papamidas/H7DDCADC/README.md

# H7DDCADC
A direct conversion software defined radio (SDR) for the shortwave range   

work in progress
