papamidas/H7DDCADC/TI_SPI/TISPI1.pdf

Making TI's ADC3660 compatible to TI's SPI mode

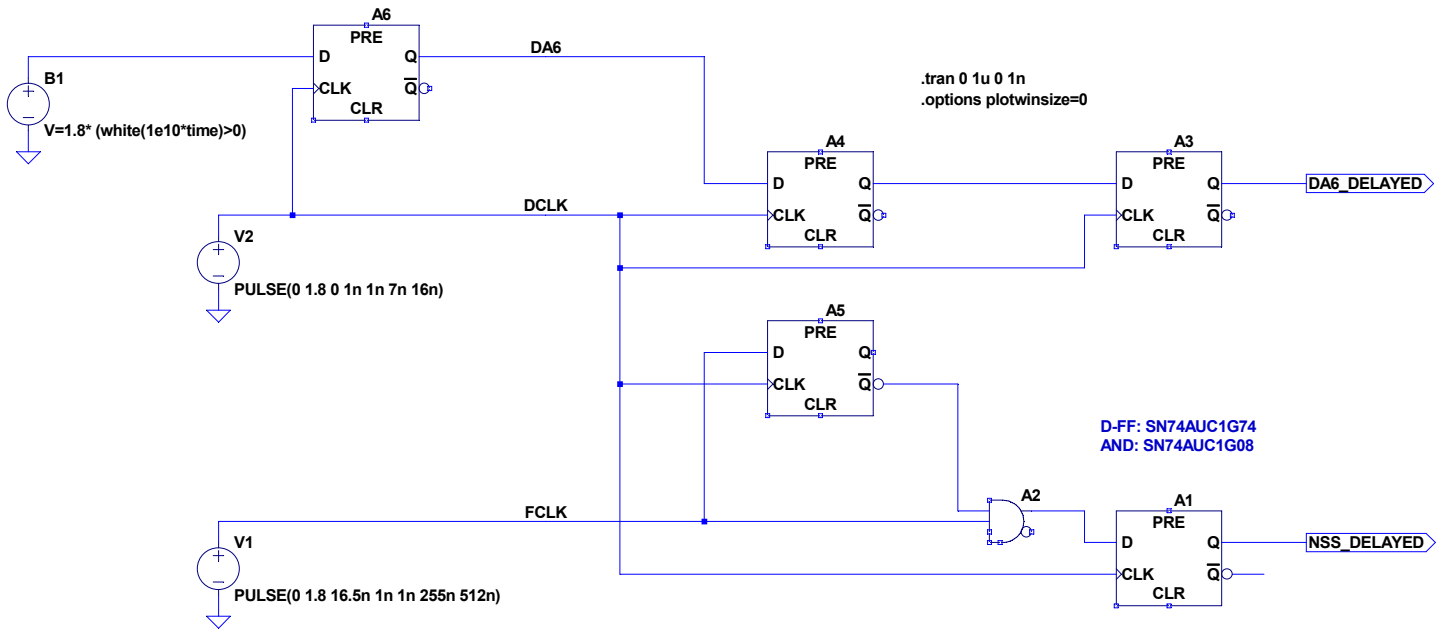
[picture p1: figure]
CLK; PRE; CLR; PULSE(0 1.8 16.5n 1n 1n 255n 512n); PULSE(0 1.8 0 1n 1n 7n 16n); V=1.8* (white(1e10*time)>0); NSS_DELAYED; FCLK; DCLK; DA6_DELAYED; .tran 0 1u 0 1n .options plotwinsize=0; D-FF: SN74AUC1G74 AND: SN74AUC1G08

# --- C:\Users\chrau\Google Drive\Amateurfunk\KiCAD\H7DDCADC\TI_SPI\TISPI.asc ---
