papamidas/H7DDCADC/TI_SPI/TI_SPI_Timing.png

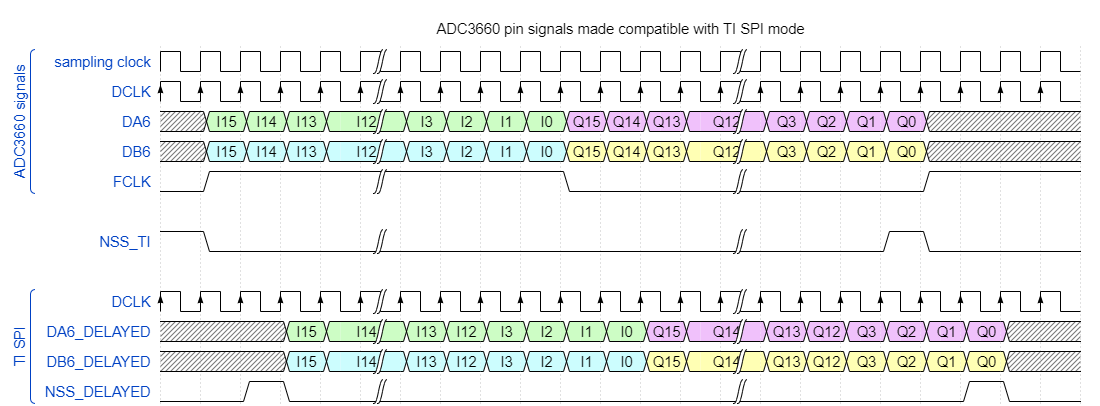
TI_SPI/TI_SPI_Timing.png
