papamidas/H7DDCADC/TI_SPI/Timing_Simu.jpg

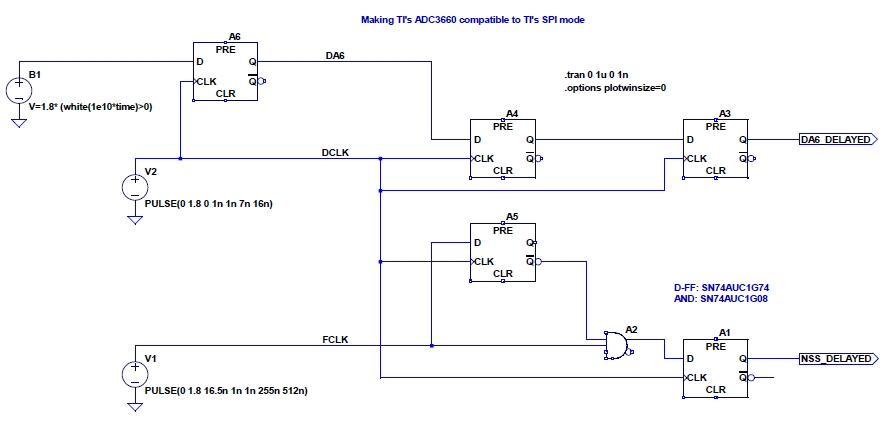
TI_SPI/Timing_Simu.jpg
