papamidas/H7DDCADC/TI_SPI/TISPI.asc

A1: dflop; Ref=0.9; Vhigh=1.8  Vlow=0; Td=1.5n   Trise=1n Tfall=1n
A2: and; Vhigh=1.8 Vlow=0; Td=1.5n Trise=1n Tfall=1n
A3: dflop; Ref=0.9; Vhigh=1.8  Vlow=0; Td=1.5n   Trise=1n Tfall=1n
A4: dflop; Ref=0.9; Vhigh=1.8  Vlow=0; Td=1.5n   Trise=1n Tfall=1n
A5: dflop; Ref=0.9; Vhigh=1.8  Vlow=0; Td=1.5n   Trise=1n Tfall=1n
A6: dflop; Ref=0.9; Vhigh=1.8  Vlow=0; Td=1.5n   Trise=1n Tfall=1n
B1: bv; V=1.8* (white(1e10*time)>0)
V1: voltage; PULSE(0 1.8 16.5n 1n 1n 255n 512n)
V2: voltage; PULSE(0 1.8 0 1n 1n 7n 16n)
Named nets: NSS_DELAYED, 0, FCLK, DCLK, DA6, DA6_DELAYED
.tran 0 1u 0 1n
.options plotwinsize=0
D-FF: SN74AUC1G74
AND: SN74AUC1G08
Making TI's ADC3660 compatible to TI's SPI mode
