papamidas/H7DDCADC/H7DDCADC.kicad_pcb

## KiCad design H7DDCADC.kicad_pcb (2022-07-26)

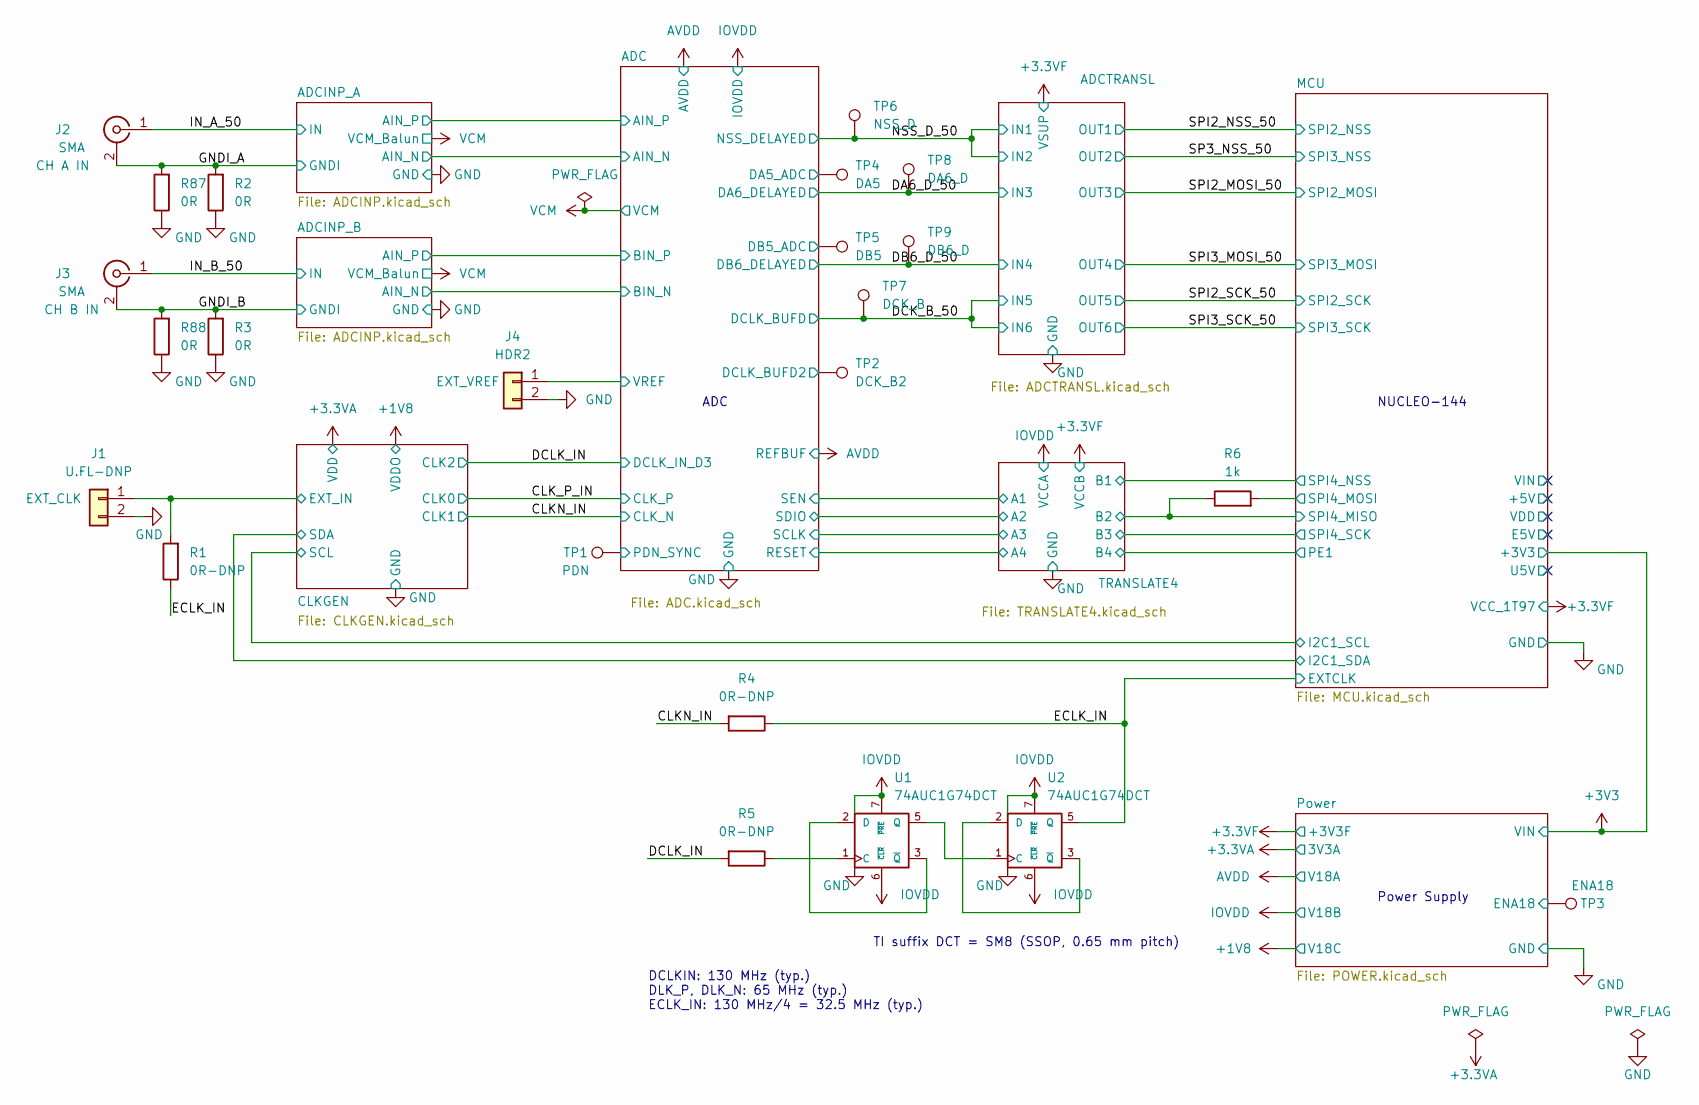
[picture p4: schematic H7DDCADC.kicad_sch]

Parts:
J1: U.FL-DNP; U.FL_Hirose_U.FL-R-SMT-1_Vertical
J2, J3: SMA; SMA_Wurth_60312002114503_Vertical
J4: HDR2; PinHeader_1x02_P2.54mm_Vertical
R1, R4, R5: 0R-DNP; R_0805_2012Metric
R2, R3, R87, R88: 0R; R_0805_2012Metric
R6: 1k; R_0805_2012Metric
TP1: PDN; TestPoint_THTPad_D1.5mm_Drill0.7mm
TP2: DCK_B2; TestPoint_THTPad_D1.5mm_Drill0.7mm
TP3: ENA18; TestPoint_THTPad_D1.5mm_Drill0.7mm
TP4: DA5; TestPoint_THTPad_D1.5mm_Drill0.7mm
TP5: DB5; TestPoint_THTPad_D1.5mm_Drill0.7mm
TP6: NSS_D; TestPoint_THTPad_D1.5mm_Drill0.7mm
TP7: DCK_B; TestPoint_THTPad_D1.5mm_Drill0.7mm
TP8: DA6_D; TestPoint_THTPad_D1.5mm_Drill0.7mm
TP9: DB6_D; TestPoint_THTPad_D1.5mm_Drill0.7mm
U1, U2: 74AUC1G74DCT; VSSOP-8_2.4x2.1mm_P0.5mm

Connections:
/ADC/DA5_ADC: TP4.1; also elsewhere on the board
/ADC/DB5_ADC: TP5.1; also elsewhere on the board
/ADC/DCLK_BUFD2: TP2.1; also elsewhere on the board
/ADC/PDN_SYNC: TP1.1; also elsewhere on the board
/ADC/VREF: J4.1; also elsewhere on the board
/CLKGEN/EXT_IN: J1.1, R1.2; also elsewhere on the board
/CLKN_IN: R4.2; also elsewhere on the board
/DA6_D_50: TP8.1; also elsewhere on the board
/DB6_D_50: TP9.1; also elsewhere on the board
/DCK_B_50: TP7.1; also elsewhere on the board
/DCLK_IN: R5.2; also elsewhere on the board
/ECLK_IN: R1.1, R4.1, U2.5 (Q); also elsewhere on the board
/GNDI_A: J2.2 (Ext), R2.2, R87.2; also elsewhere on the board
/GNDI_B: J3.2 (Ext), R3.2, R88.2; also elsewhere on the board
/IN_A_50: J2.1 (In); also elsewhere on the board
/IN_B_50: J3.1 (In); also elsewhere on the board
/MCU/SPI4_MISO: R6.1; also elsewhere on the board
/MCU/SPI4_MOSI: R6.2; also elsewhere on the board
/NSS_D_50: TP6.1; also elsewhere on the board
/Power/ENA18: TP3.1; also elsewhere on the board
GND: J1.2, J4.2, R2.1, R3.1, R87.1, R88.1, U1.4 (GND), U2.4 (GND); also elsewhere on the board
IOVDD: U1.6 (~CLR), U1.7 (~PRE), U1.8 (VCC), U2.6 (~CLR), U2.7 (~PRE), U2.8 (VCC); also elsewhere on the board
unnamed: R5.1, U1.1 (C)
unnamed: U1.2 (D), U1.3 (~Q)
unnamed: U1.5 (Q), U2.1 (C)
unnamed: U2.2 (D), U2.3 (~Q)

Notes on the sheet:
Power Supply
NUCLEO-144
DCLKIN: 130 MHz (typ.) DLK_P, DLK_N: 65 MHz (typ.) ECLK_IN: 130 MHz/4 = 32.5 MHz (typ.)
TI suffix DCT = SM8 (SSOP, 0.65 mm pitch)
ADC

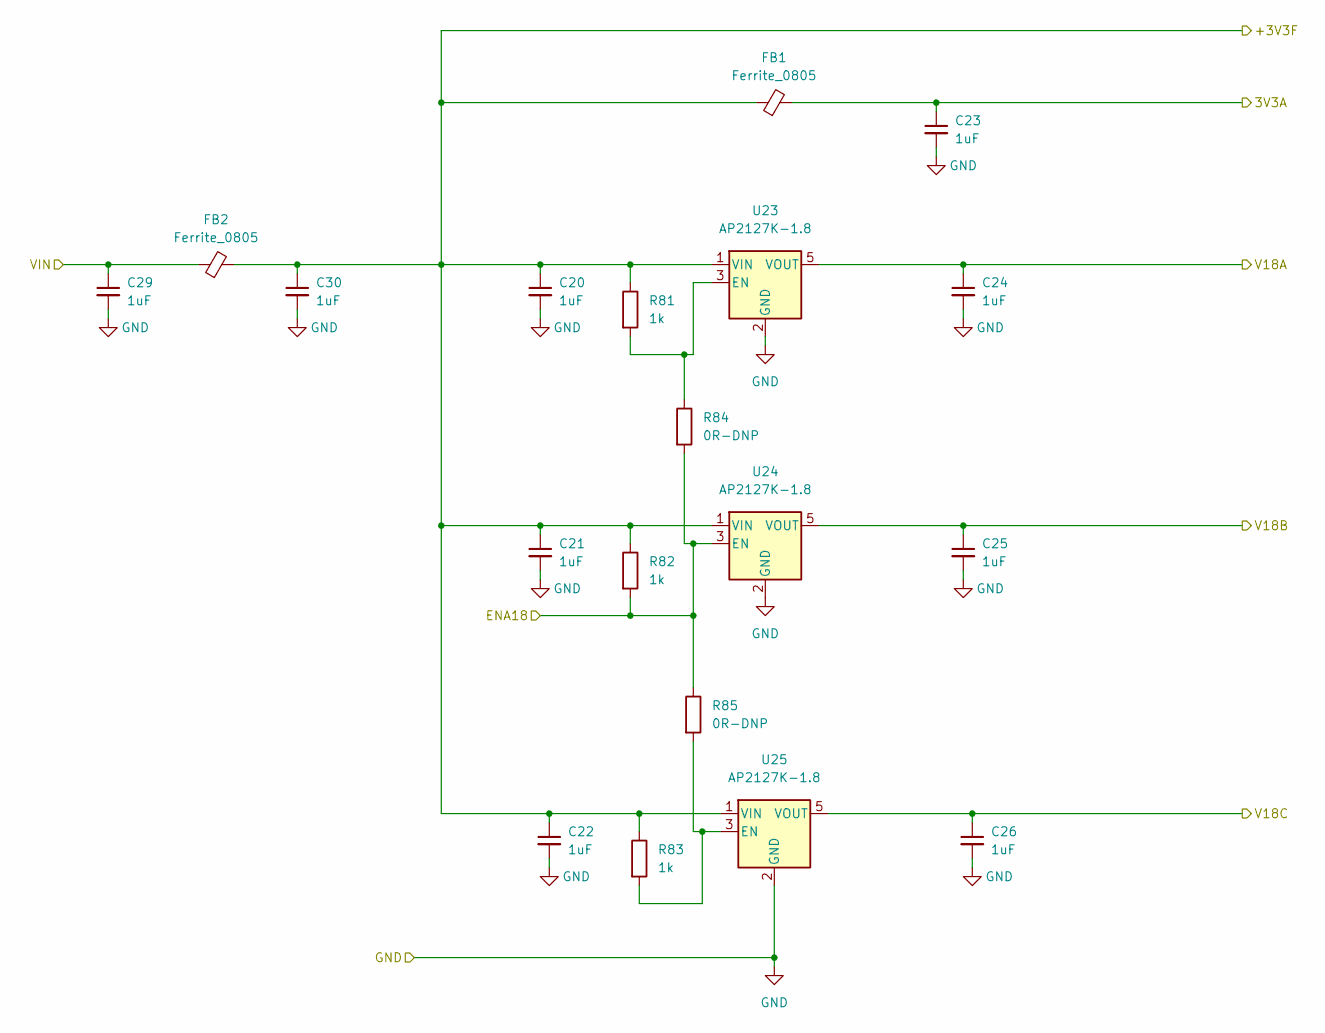
[picture p5: schematic POWER.kicad_sch, H7DDCADC]

Parts:
C20, C21, C22, C23, C24, C25, C26, C29, C30: 1uF; C_0805_2012Metric
FB1, FB2: Ferrite_0805; R_0805_2012Metric
R81, R82, R83: 1k; R_0805_2012Metric
R84, R85: 0R-DNP; R_0805_2012Metric
U23, U24, U25: AP2127K-1.8; SOT-23-5

Connections:
+1V8: C26.1, U25.5 (VOUT); also elsewhere on the board
+3.3VF: C20.1, C21.1, C22.1, C30.1, FB1.1, FB2.2, R81.1, R82.1, R83.1, U23.1 (VIN), U24.1 (VIN), U25.1 (VIN); also elsewhere on the board
+3V3: C29.1, FB2.1; also elsewhere on the board
/Power/ENA18: R82.2, R84.2, R85.1, U24.3 (EN); also elsewhere on the board
AVDD: C24.1, U23.5 (VOUT); also elsewhere on the board
GND: C20.2, C21.2, C22.2, C23.2, C24.2, C25.2, C26.2, C29.2, C30.2, U23.2 (GND), U24.2 (GND), U25.2 (GND); also elsewhere on the board
IOVDD: C25.1, U24.5 (VOUT); also elsewhere on the board
unnamed: R81.2, R84.1, U23.3 (EN)
unnamed: R83.2, R85.2, U25.3 (EN)

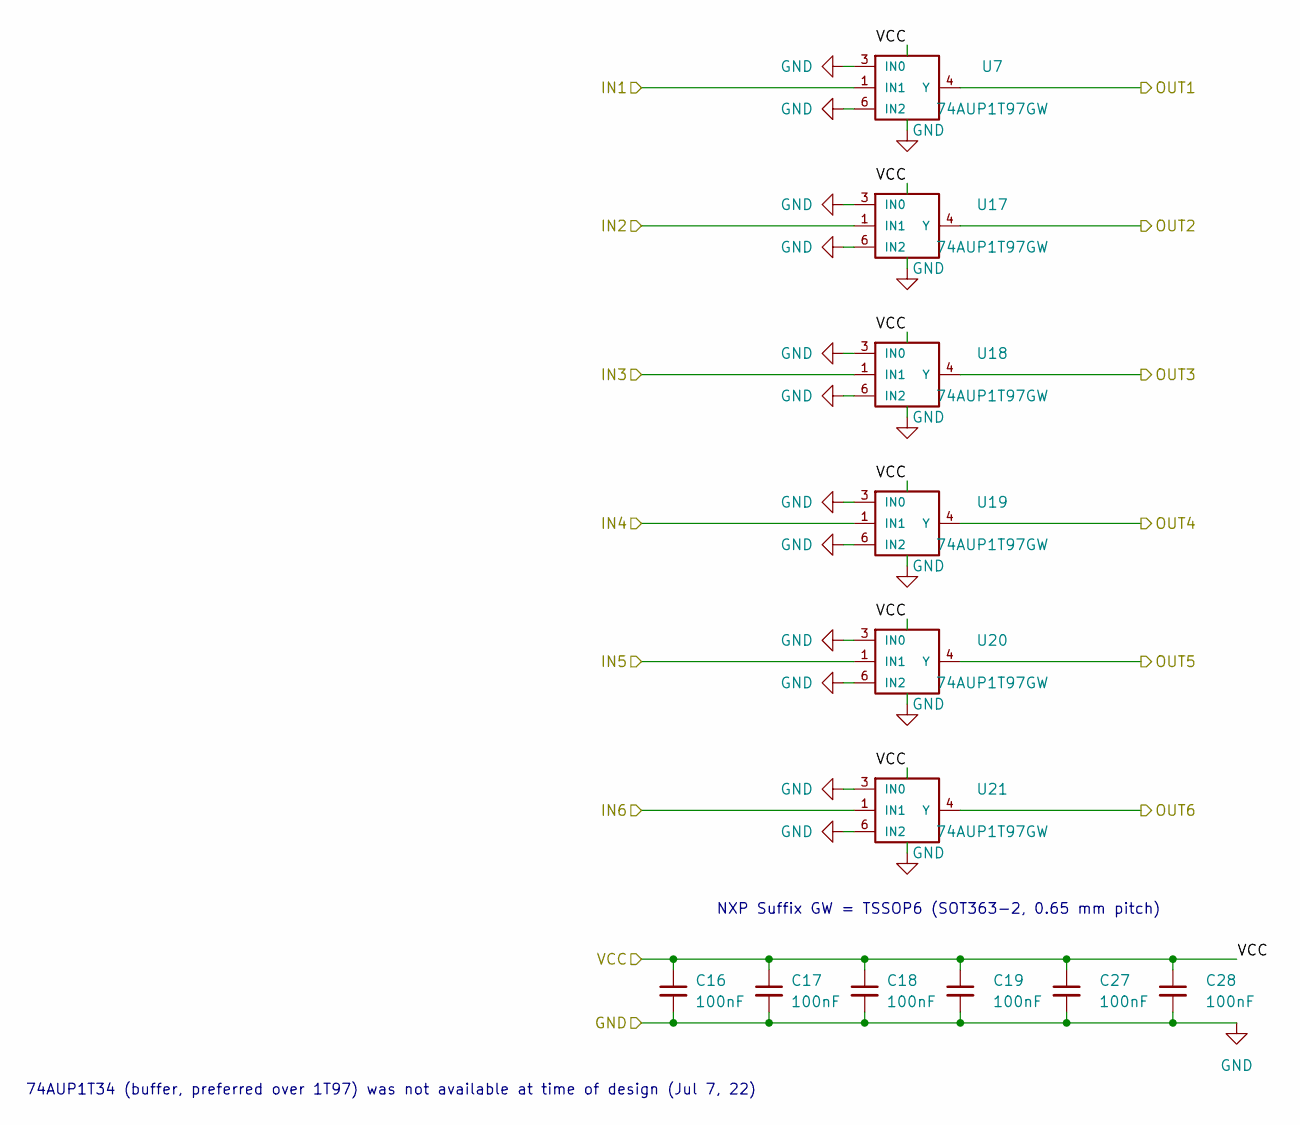
[picture p6: schematic ADCTRANSL.kicad_sch, H7DDCADC]

Parts:
C16, C17, C18, C19, C27, C28: 100nF; C_0805_2012Metric
U7, U17, U18, U19, U20, U21: 74AUP1T97GW; SOT-363_SC-70-6_Handsoldering

Connections:
/DA6_D_50: U18.1 (IN1); also elsewhere on the board
/DB6_D_50: U19.1 (IN1); also elsewhere on the board
/DCK_B_50: U20.1 (IN1), U21.1 (IN1); also elsewhere on the board
/NSS_D_50: U7.1 (IN1), U17.1 (IN1); also elsewhere on the board
/SP3_NSS_50: U17.4 (Y); also elsewhere on the board
/SPI2_MOSI_50: U18.4 (Y); also elsewhere on the board
/SPI2_NSS_50: U7.4 (Y); also elsewhere on the board
/SPI2_SCK_50: U20.4 (Y); also elsewhere on the board
/SPI3_MOSI_50: U19.4 (Y); also elsewhere on the board
/SPI3_SCK_50: U21.4 (Y); also elsewhere on the board
GND: C16.2, C17.2, C18.2, C19.2, C27.2, C28.2, U7.2 (GND), U7.3 (IN0), U7.6 (IN2), U17.2 (GND), U17.3 (IN0), U17.6 (IN2), U18.2 (GND), U18.3 (IN0), U18.6 (IN2), U19.2 (GND), U19.3 (IN0), U19.6 (IN2), U20.2 (GND), U20.3 (IN0), U20.6 (IN2), U21.2 (GND), U21.3 (IN0), U21.6 (IN2); also elsewhere on the board
V1T97: C16.1, C17.1, C18.1, C19.1, C27.1, C28.1, U7.5 (VCC), U17.5 (VCC), U18.5 (VCC), U19.5 (VCC), U20.5 (VCC), U21.5 (VCC); also elsewhere on the board

Notes on the sheet:
74AUP1T34 (buffer, preferred over 1T97) was not available at time of design (Jul 7, 22)
NXP Suffix GW = TSSOP6 (SOT363-2, 0.65 mm pitch)

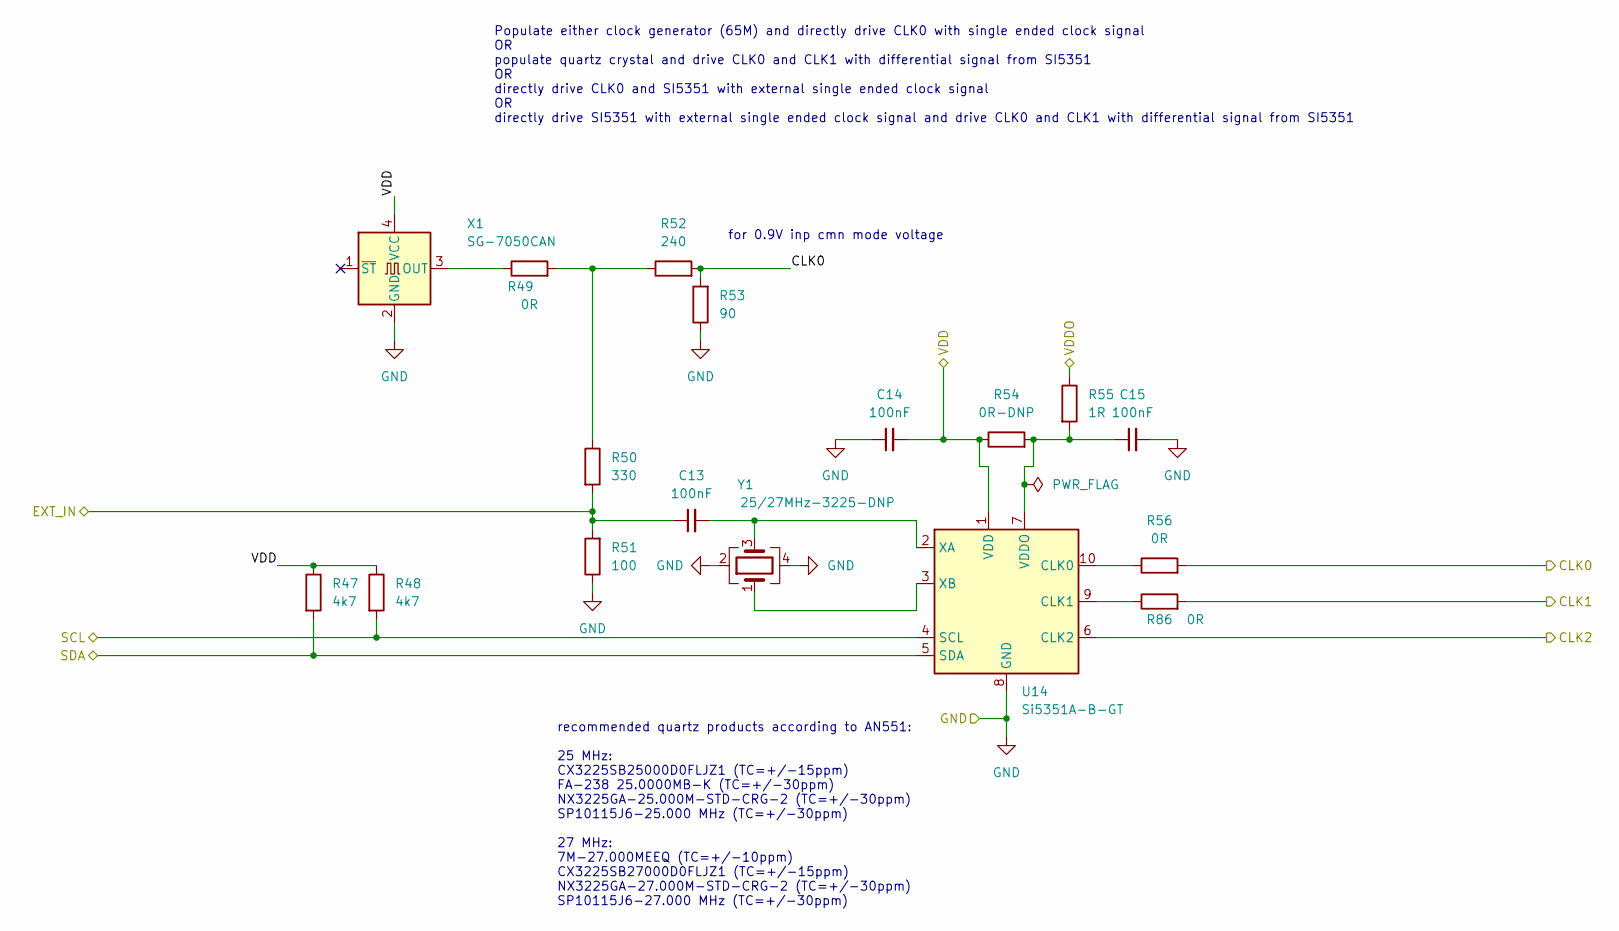
[picture p7: schematic CLKGEN.kicad_sch, H7DDCADC]

Parts:
C13, C14, C15: 100nF; C_0805_2012Metric
R47, R48: 4k7; R_0805_2012Metric
R49, R56, R86: 0R; R_0805_2012Metric
R50: 330; R_0805_2012Metric
R51: 100; R_0805_2012Metric
R52: 240; R_0805_2012Metric
R53: 90; R_0805_2012Metric
R54: 0R-DNP; R_0805_2012Metric
R55: 1R; R_0805_2012Metric
U14: Si5351A-B-GT; MSOP-10_3x3mm_P0.5mm
X1: SG-7050CAN; Oscillator_SMD_SeikoEpson_SG8002CA-4Pin_7.0x5.0mm
Y1: 25/27MHz-3225-DNP; Crystal_SMD_3225-4Pin_3.2x2.5mm_HandSoldering

Connections:
+1V8: R55.1; also elsewhere on the board
/CLKGEN/EXT_IN: C13.1, R50.2, R51.2; also elsewhere on the board
/CLKGEN/SCL: R48.2, U14.4 (SCL); also elsewhere on the board
/CLKGEN/SDA: R47.2, U14.5 (SDA); also elsewhere on the board
/CLKN_IN: R86.2; also elsewhere on the board
/CLK_P_IN: R52.2, R53.2, R56.2; also elsewhere on the board
/DCLK_IN: U14.6 (CLK2); also elsewhere on the board
GND: C14.1, C15.2, R51.1, R53.1, U14.8 (GND), X1.2 (GND), Y1.2, Y1.4; also elsewhere on the board
unnamed: C13.2, U14.2 (XA), Y1.3
unnamed: C15.1, R54.2, R55.2, U14.7 (VDDO)
unnamed: R49.1, X1.3 (OUT)
unnamed: R49.2, R50.1, R52.1
unnamed: R56.1, U14.10 (CLK0)
unnamed: R86.1, U14.9 (CLK1)
unnamed: U14.3 (XB), Y1.1

Notes on the sheet:
Populate either clock generator (65M) and directly drive CLK0 with single ended clock signal OR populate quartz crystal and drive CLK0 and CLK1 with differential signal from SI5351 OR directly drive CLK0 and SI5351 with external single ended clock signal OR directly drive SI5351 with external singl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
for 0.9V inp cmn mode voltage
recommended quartz products according to AN551: 25 MHz: CX3225SB25000D0FLJZ1 (TC=+/-15ppm) FA-238 25.0000MB-K (TC=+/-30ppm) NX3225GA-25.000M-STD-CRG-2 (TC=+/-30ppm) SP10115J6-25.000 MHz (TC=+/-30ppm) 27 MHz: 7M-27.000MEEQ (TC=+/-10ppm) CX3225SB27000D0FLJZ1 (TC=+/-15ppm) NX3225GA-27.000M-STD-CRG-2 (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

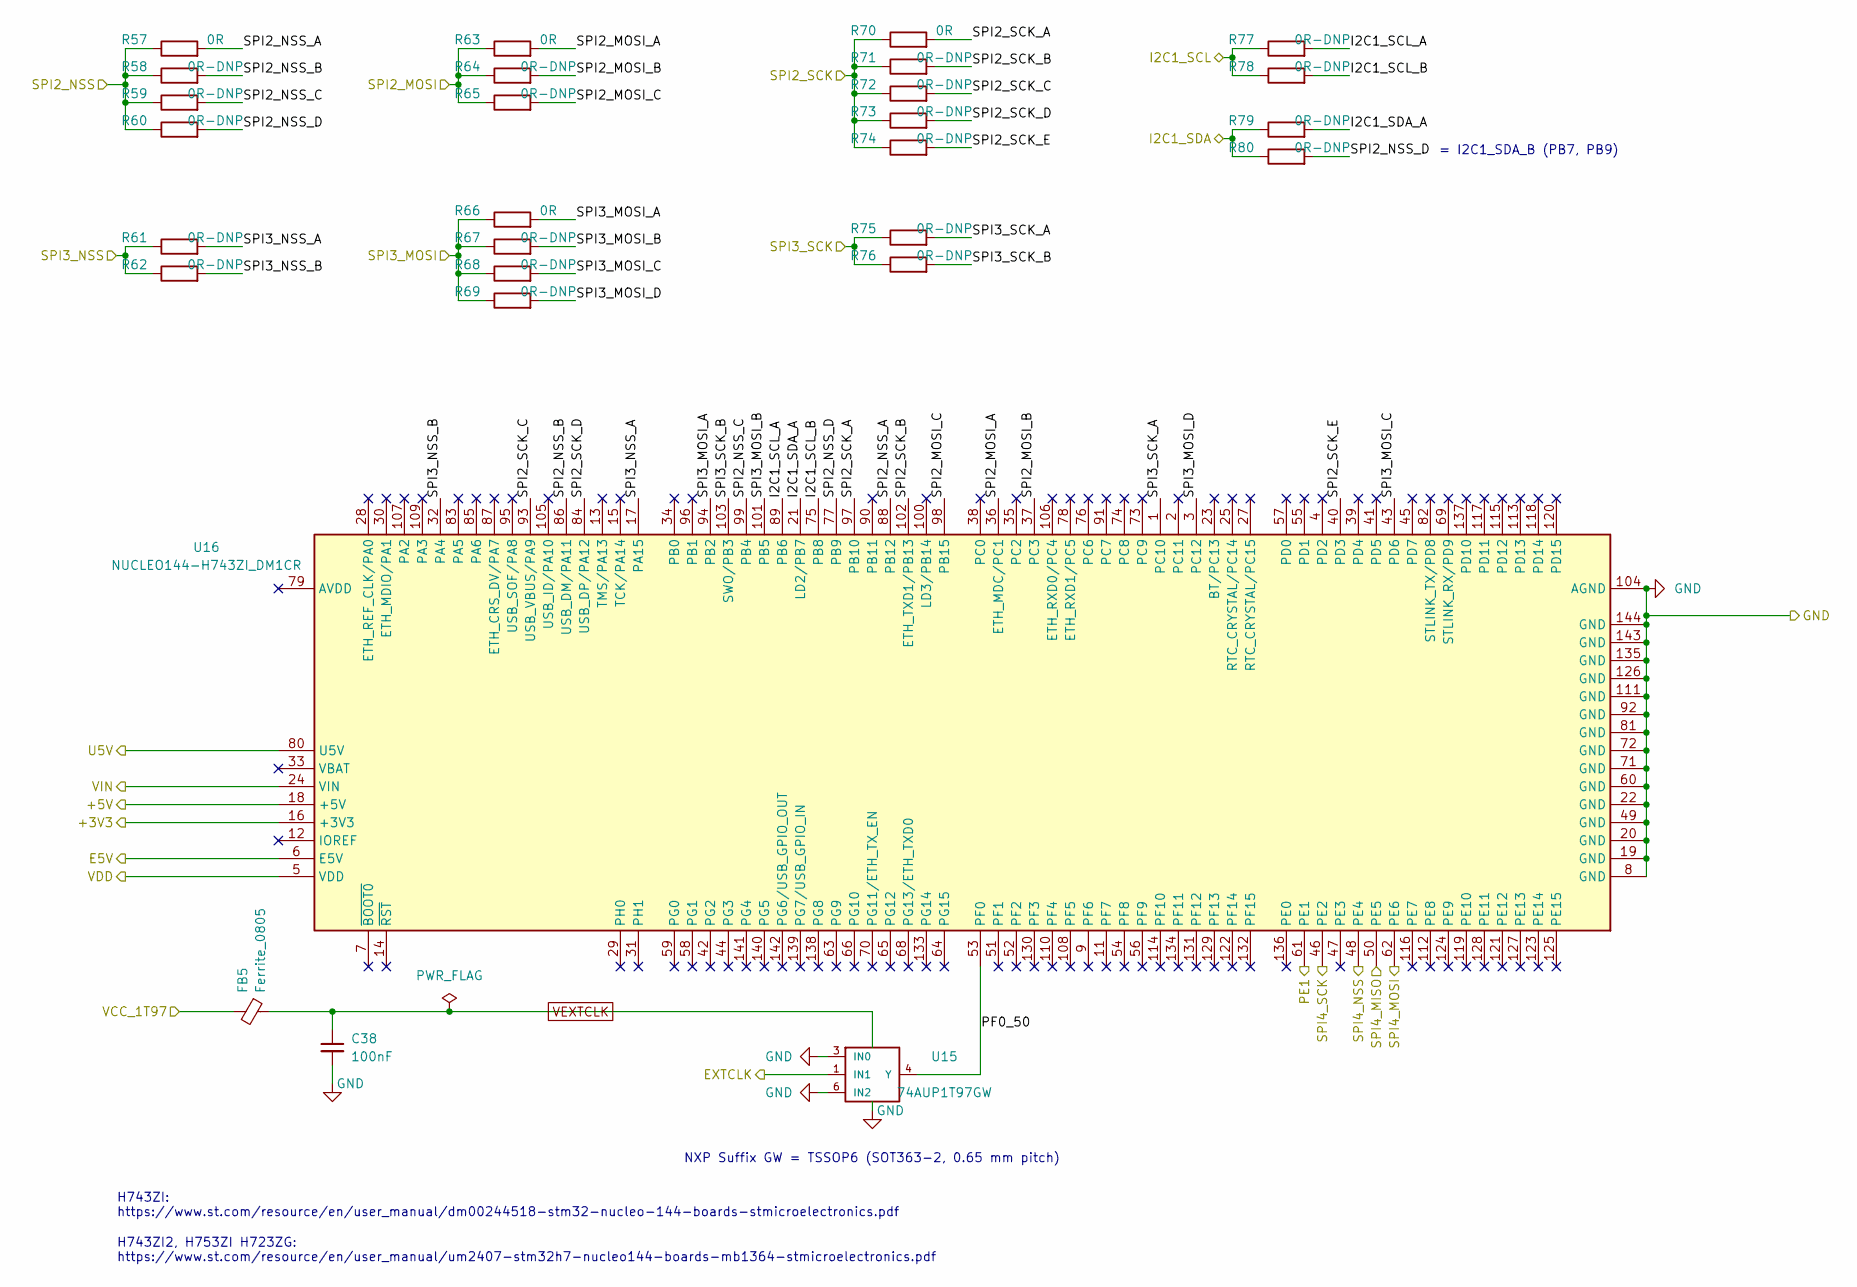
[picture p8: schematic MCU.kicad_sch, H7DDCADC]

Parts:
C38: 100nF; C_0805_2012Metric
FB5: Ferrite_0805; R_0805_2012Metric
R57, R63, R66, R70: 0R; R_0402_1005Metric_Pad0.72x0.64mm_HandSolder
R58, R59, R60, R61, R62, R64, R65, R67, R68, R69, R71, R72, R73, R74, R75, R76, R77, R78, R79, R80: 0R-DNP; R_0402_1005Metric_Pad0.72x0.64mm_HandSolder
U15: 74AUP1T97GW; SOT-363_SC-70-6_Handsoldering
U16: NUCLEO144-H743ZI_DM1CR; ST_Morpho_Connector_144_STLink

Connections:
+3.3VF: FB5.2; also elsewhere on the board
+3V3: U16.16 (+3V3); also elsewhere on the board
/CLKGEN/SCL: R77.1, R78.1; also elsewhere on the board
/CLKGEN/SDA: R79.1, R80.1; also elsewhere on the board
/ECLK_IN: U15.1 (IN1); also elsewhere on the board
/MCU/+5V: U16.18 (+5V); also elsewhere on the board
/MCU/E5V: U16.6 (E5V); also elsewhere on the board
/MCU/I2C1_SCL_A: R77.2, U16.89 (PB6); also elsewhere on the board
/MCU/I2C1_SCL_B: R78.2, U16.75 (PB8); also elsewhere on the board
/MCU/I2C1_SDA_A: R79.2, U16.21 (LD2/PB7); also elsewhere on the board
/MCU/PE1: U16.61 (PE1); also elsewhere on the board
/MCU/PF0_50: U15.4 (Y), U16.53 (PF0); also elsewhere on the board
/MCU/SPI2_MOSI_A: R63.2, U16.36 (ETH_MDC/PC1); also elsewhere on the board
/MCU/SPI2_MOSI_B: R64.2, U16.37 (PC3); also elsewhere on the board
/MCU/SPI2_MOSI_C: R65.2, U16.98 (PB15); also elsewhere on the board
/MCU/SPI2_NSS_A: R57.2, U16.88 (PB12); also elsewhere on the board
/MCU/SPI2_NSS_B: R58.2, U16.86 (USB_DM/PA11); also elsewhere on the board
/MCU/SPI2_NSS_C: R59.2, U16.99 (PB4); also elsewhere on the board
/MCU/SPI2_NSS_D: R60.2, R80.2, U16.77 (PB9); also elsewhere on the board
/MCU/SPI2_SCK_A: R70.2, U16.97 (PB10); also elsewhere on the board
/MCU/SPI2_SCK_B: R71.2, U16.102 (ETH_TXD1/PB13); also elsewhere on the board
/MCU/SPI2_SCK_C: R72.2, U16.93 (USB_VBUS/PA9); also elsewhere on the board
/MCU/SPI2_SCK_D: R73.2, U16.84 (USB_DP/PA12); also elsewhere on the board
/MCU/SPI2_SCK_E: R74.2, U16.40 (PD3); also elsewhere on the board
/MCU/SPI3_MOSI_A: R66.2, U16.94 (PB2); also elsewhere on the board
/MCU/SPI3_MOSI_B: R67.2, U16.101 (PB5); also elsewhere on the board
/MCU/SPI3_MOSI_C: R68.2, U16.43 (PD6); also elsewhere on the board
/MCU/SPI3_MOSI_D: R69.2, U16.3 (PC12); also elsewhere on the board
/MCU/SPI3_NSS_A: R61.2, U16.17 (PA15); also elsewhere on the board
/MCU/SPI3_NSS_B: R62.2, U16.32 (PA4); also elsewhere on the board
/MCU/SPI3_SCK_A: R75.2, U16.1 (PC10); also elsewhere on the board
/MCU/SPI3_SCK_B: R76.2, U16.103 (SWO/PB3); also elsewhere on the board
/MCU/SPI4_MISO: U16.50 (PE5); also elsewhere on the board
/MCU/SPI4_MOSI: U16.62 (PE6); also elsewhere on the board
/MCU/SPI4_NSS: U16.48 (PE4); also elsewhere on the board
/MCU/SPI4_SCK: U16.46 (PE2); also elsewhere on the board
/MCU/U5V: U16.80 (U5V); also elsewhere on the board
/MCU/VDD: U16.5 (VDD); also elsewhere on the board
/MCU/VIN: U16.24 (VIN); also elsewhere on the board
/SP3_NSS_50: R61.1, R62.1; also elsewhere on the board
/SPI2_MOSI_50: R63.1, R64.1, R65.1; also elsewhere on the board
/SPI2_NSS_50: R57.1, R58.1, R59.1, R60.1; also elsewhere on the board
/SPI2_SCK_50: R70.1, R71.1, R72.1, R73.1, R74.1; also elsewhere on the board
/SPI3_MOSI_50: R66.1, R67.1, R68.1, R69.1; also elsewhere on the board
/SPI3_SCK_50: R75.1, R76.1; also elsewhere on the board
GND: C38.2, U15.2 (GND), U15.3 (IN0), U15.6 (IN2), U16.8 (GND), U16.19 (GND), U16.20 (GND), U16.22 (GND), U16.49 (GND), U16.60 (GND), U16.71 (GND), U16.72 (GND), U16.81 (GND), U16.92 (GND), U16.104 (AGND), U16.111 (GND), U16.126 (GND), U16.135 (GND), U16.143 (GND), U16.144 (GND); also elsewhere on the board
VEXTCLK: C38.1, FB5.1, U15.5 (VCC)

Notes on the sheet:
= I2C1_SDA_B (PB7, PB9)
NXP Suffix GW = TSSOP6 (SOT363-2, 0.65 mm pitch)
H743ZI2, H753ZI H723ZG: https://www.st.com/resource/en/user_manual/um2407-stm32h7-nucleo144-boards-mb1364-stmicroelectronics.pdf
H743ZI: https://www.st.com/resource/en/user_manual/dm00244518-stm32-nucleo-144-boards-stmicroelectronics.pdf

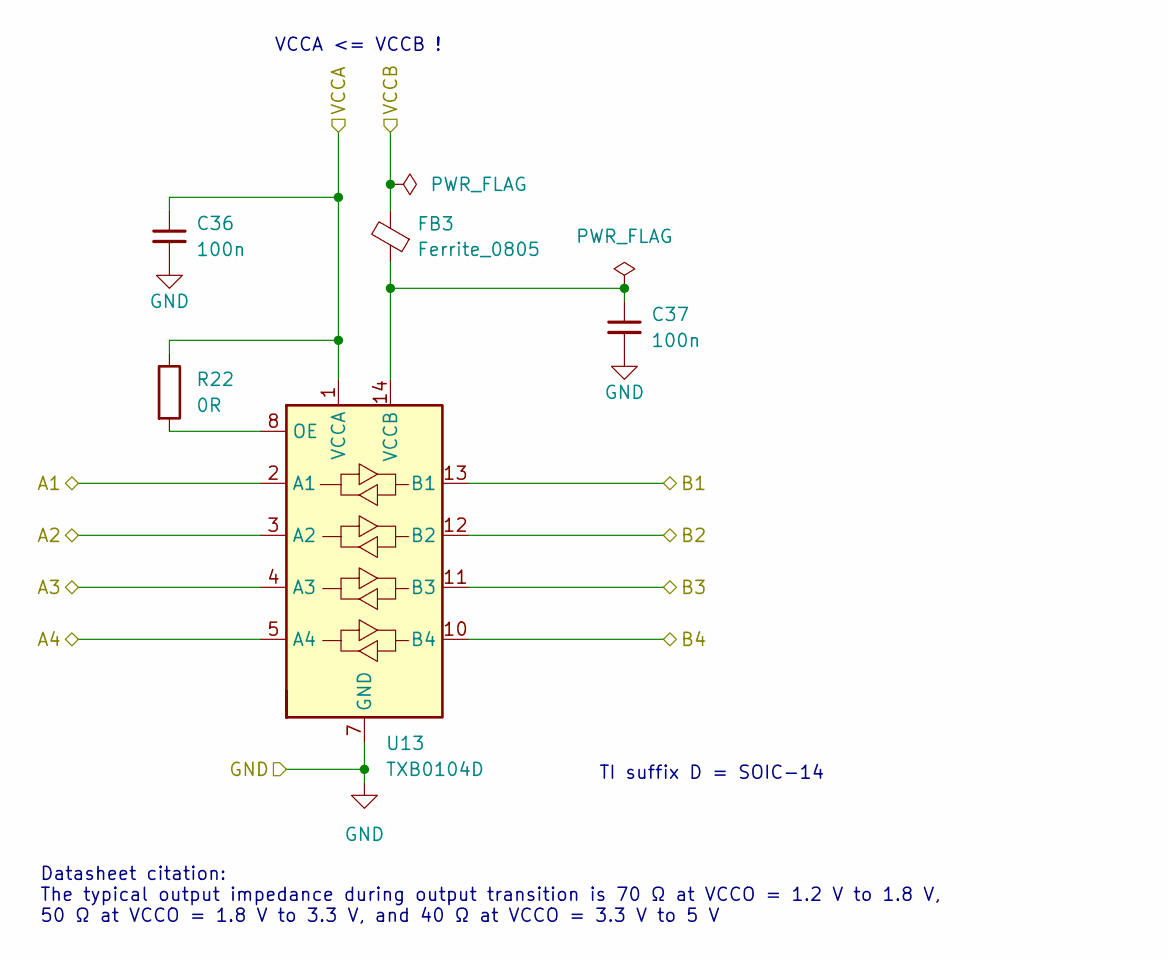
[picture p9: schematic TRANSLATE4.kicad_sch, H7DDCADC]

Parts:
C36, C37: 100n; C_0402_1005Metric_Pad0.74x0.62mm_HandSolder
FB3: Ferrite_0805; R_0805_2012Metric
R22: 0R; R_0805_2012Metric
U13: TXB0104D; SOIC-14_3.9x8.7mm_P1.27mm

Connections:
/ADC/RESET: U13.5 (A4); also elsewhere on the board
/ADC/SCLK: U13.4 (A3); also elsewhere on the board
/ADC/SDIO: U13.3 (A2); also elsewhere on the board
/ADC/SEN: U13.2 (A1); also elsewhere on the board
/MCU/PE1: U13.10 (B4); also elsewhere on the board
/MCU/SPI4_MISO: U13.12 (B2); also elsewhere on the board
/MCU/SPI4_NSS: U13.13 (B1); also elsewhere on the board
/MCU/SPI4_SCK: U13.11 (B3); also elsewhere on the board
GND: C36.2, C37.2, U13.7 (GND); also elsewhere on the board
IOVDD: C36.1, R22.1, U13.1 (VCCA); also elsewhere on the board
unnamed: R22.2, U13.8 (OE)

Notes on the sheet:
TI suffix D = SOIC-14
Datasheet citation: The typical output impedance during output transition is 70 Ω at VCCO = 1.2 V to 1.8 V, 50 Ω at VCCO = 1.8 V to 3.3 V, and 40 Ω at VCCO = 3.3 V to 5 V
VCCA <= VCCB !

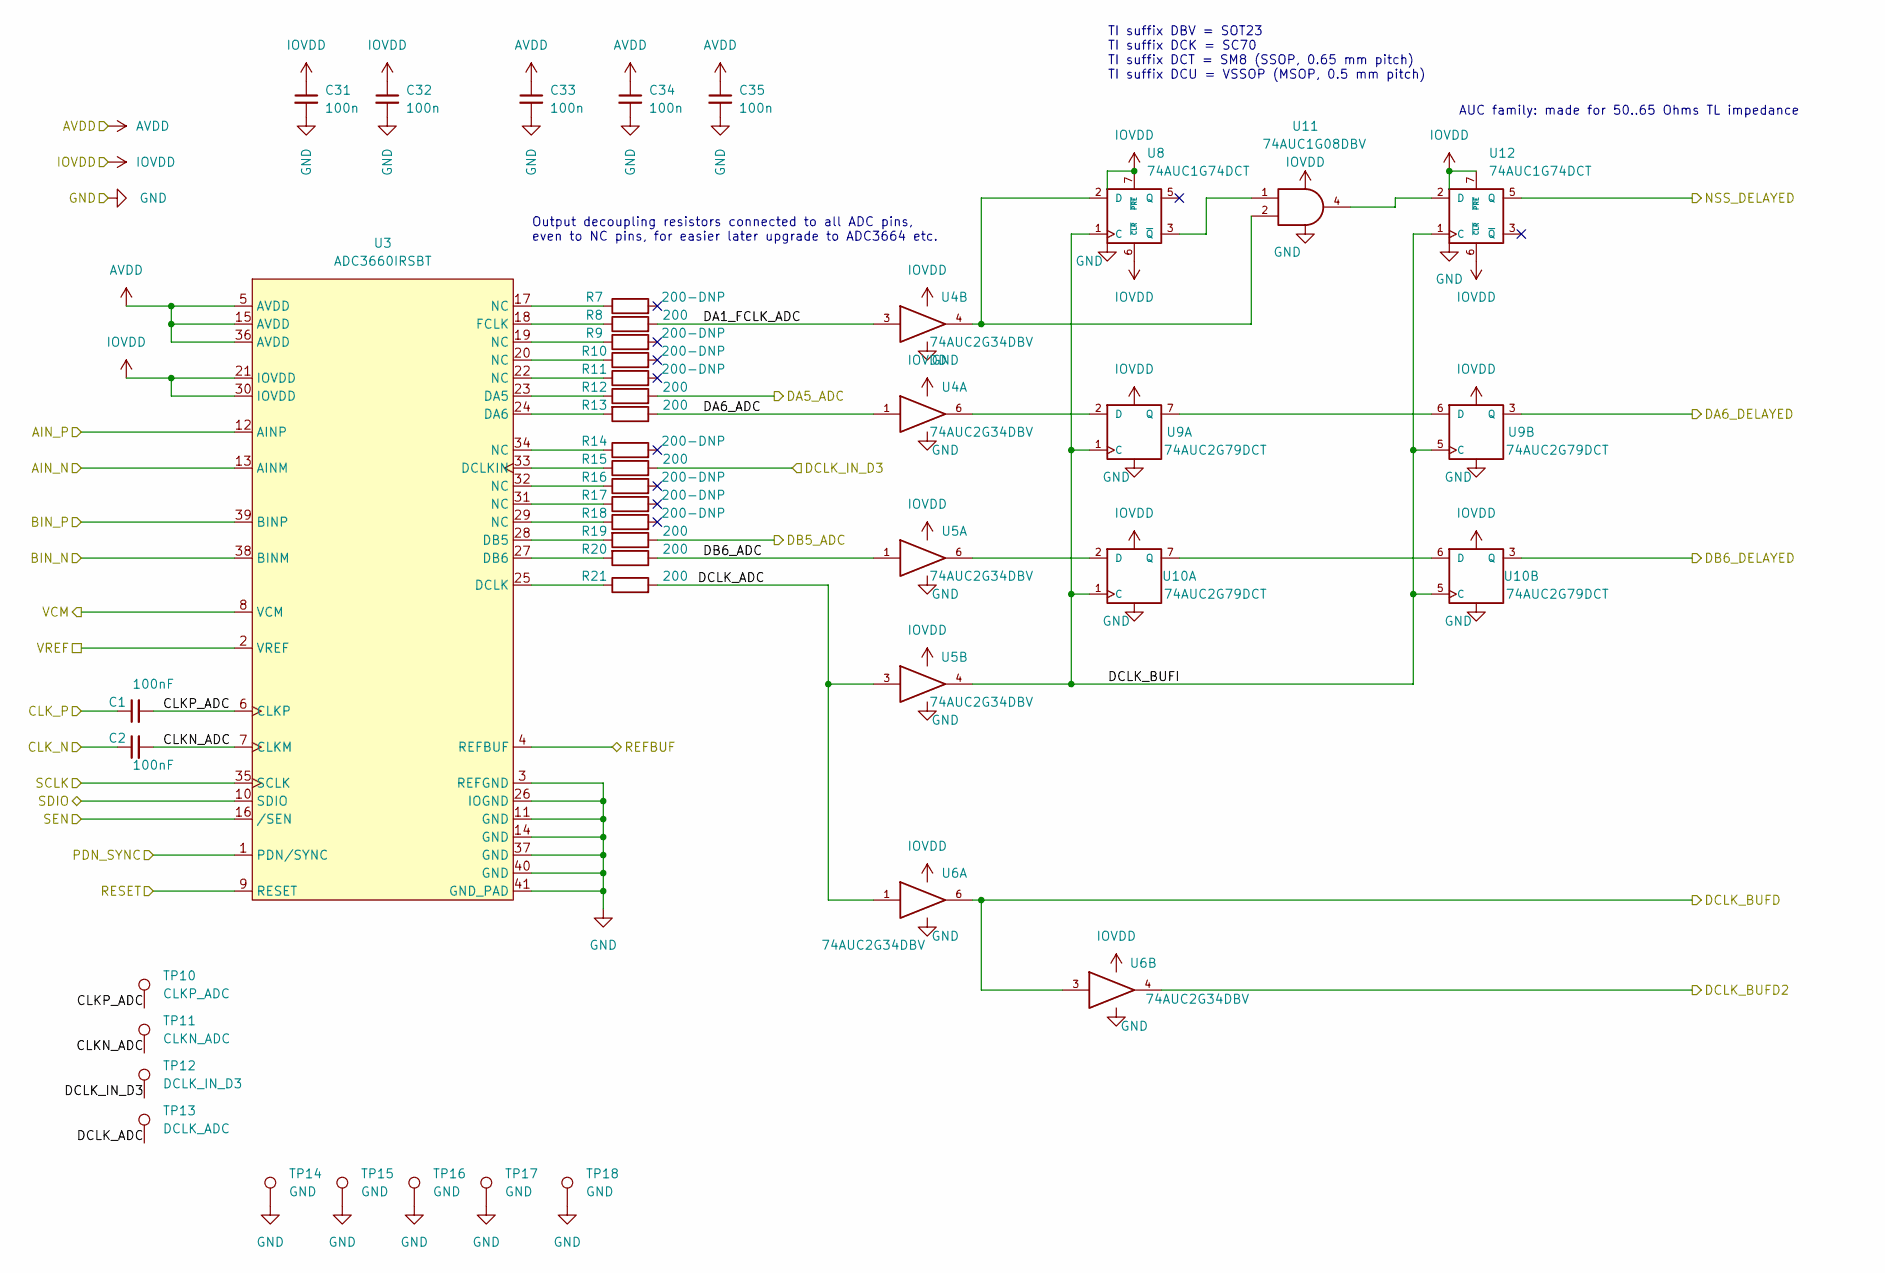
[picture p10: schematic ADC.kicad_sch, H7DDCADC]

Parts:
C1, C2: 100nF; C_0805_2012Metric
C31, C32, C33, C34, C35: 100n; C_0402_1005Metric_Pad0.74x0.62mm_HandSolder
R7, R9, R10, R11, R14, R16, R17, R18: 200-DNP; R_0402_1005Metric_Pad0.72x0.64mm_HandSolder
R8, R12, R13, R15, R19, R20, R21: 200; R_0402_1005Metric_Pad0.72x0.64mm_HandSolder
TP10: CLKP_ADC; TestPoint_THTPad_D1.5mm_Drill0.7mm
TP11: CLKN_ADC; TestPoint_THTPad_D1.5mm_Drill0.7mm
TP12: DCLK_IN_D3; TestPoint_THTPad_D1.5mm_Drill0.7mm
TP13: DCLK_ADC; TestPoint_THTPad_D1.5mm_Drill0.7mm
TP14, TP15, TP16, TP17, TP18: GND; TestPoint_THTPad_D1.5mm_Drill0.7mm
U3: ADC3660IRSBT; QFN-40-1EP_5x5mm_P0.4mm_EP3.6x3.6mm
U4, U5, U6: 74AUC2G34DBV; SOT-23-6_Handsoldering
U8, U12: 74AUC1G74DCT; VSSOP-8_2.4x2.1mm_P0.5mm
U9, U10: 74AUC2G79DCT; MSOP-8_3x3mm_P0.65mm
U11: 74AUC1G08DBV; SOT-23-5

Connections:
/ADC/AIN_N: U3.13 (AINM); also elsewhere on the board
/ADC/AIN_P: U3.12 (AINP); also elsewhere on the board
/ADC/BIN_N: U3.38 (BINM); also elsewhere on the board
/ADC/BIN_P: U3.39 (BINP); also elsewhere on the board
/ADC/CLKN_ADC: C2.2, TP11.1, U3.7 (CLKM); also elsewhere on the board
/ADC/CLKP_ADC: C1.2, TP10.1, U3.6 (CLKP); also elsewhere on the board
/ADC/DA1_FCLK_ADC: R8.2, U4.3
/ADC/DA5_ADC: R12.2; also elsewhere on the board
/ADC/DA6_ADC: R13.1, U4.1
/ADC/DB5_ADC: R19.1; also elsewhere on the board
/ADC/DB6_ADC: R20.1, U5.1
/ADC/DCLK_ADC: R21.2, TP13.1, U5.3, U6.1
/ADC/DCLK_BUFD2: U6.4; also elsewhere on the board
/ADC/DCLK_BUFI: U5.4, U8.1 (C), U9.1 (C), U9.5 (C), U10.1 (C), U10.5 (C), U12.1 (C)
/ADC/PDN_SYNC: U3.1 (PDN/SYNC); also elsewhere on the board
/ADC/RESET: U3.9 (RESET); also elsewhere on the board
/ADC/SCLK: U3.35 (SCLK); also elsewhere on the board
/ADC/SDIO: U3.10 (SDIO); also elsewhere on the board
/ADC/SEN: U3.16 (/SEN); also elsewhere on the board
/ADC/VREF: U3.2 (VREF); also elsewhere on the board
/CLKN_IN: C2.1; also elsewhere on the board
/CLK_P_IN: C1.1; also elsewhere on the board
/DA6_D_50: U9.3 (Q); also elsewhere on the board
/DB6_D_50: U10.3 (Q); also elsewhere on the board
/DCK_B_50: U6.3, U6.6; also elsewhere on the board
/DCLK_IN: R15.2, TP12.1; also elsewhere on the board
/NSS_D_50: U12.5 (Q); also elsewhere on the board
AVDD: C33.1, C34.1, C35.1, U3.4 (REFBUF), U3.5 (AVDD), U3.15 (AVDD), U3.36 (AVDD); also elsewhere on the board
GND: C31.2, C32.2, C33.2, C34.2, C35.2, TP14.1, TP15.1, TP16.1, TP17.1, TP18.1, U3.3 (REFGND), U3.11 (GND), U3.14 (GND), U3.26 (IOGND), U3.37 (GND), U3.40 (GND), U3.41 (GND_PAD), U4.2 (GND), U5.2 (GND), U6.2 (GND), U8.4 (GND), U9.4 (GND), U10.4 (GND), U11.3 (GND), U12.4 (GND); also elsewhere on the board
IOVDD: C31.1, C32.1, U3.21 (IOVDD), U3.30 (IOVDD), U4.5 (VCC), U5.5 (VCC), U6.5 (VCC), U8.6 (~CLR), U8.7 (~PRE), U8.8 (VCC), U9.8 (VCC), U10.8 (VCC), U11.5 (VCC), U12.6 (~CLR), U12.7 (~PRE), U12.8 (VCC); also elsewhere on the board
unnamed 107: R7.1, U3.17 (NC); also elsewhere on the board
unnamed 108: R8.1, U3.18 (FCLK); also elsewhere on the board
unnamed 109: R9.1, U3.19 (NC); also elsewhere on the board
unnamed 110: R10.1, U3.20 (NC); also elsewhere on the board
unnamed 111: R11.1, U3.22 (NC); also elsewhere on the board
unnamed 112: R12.1, U3.23 (DA5); also elsewhere on the board
unnamed 113: R13.2, U3.24 (DA6); also elsewhere on the board
unnamed 114: R14.1, U3.34 (NC); also elsewhere on the board
unnamed 115: R15.1, U3.33 (DCLKIN); also elsewhere on the board
unnamed 116: R16.1, U3.32 (NC); also elsewhere on the board
unnamed 117: R17.1, U3.31 (NC); also elsewhere on the board
unnamed 118: R18.1, U3.29 (NC); also elsewhere on the board
unnamed 119: R19.2, U3.28 (DB5); also elsewhere on the board
unnamed 120: R20.2, U3.27 (DB6); also elsewhere on the board
unnamed 121: R21.1, U3.25 (DCLK); also elsewhere on the board
unnamed: U4.6, U9.2 (D)
unnamed: U9.6 (D), U9.7 (Q)
unnamed: U5.6, U10.2 (D)
unnamed: U10.6 (D), U10.7 (Q)
unnamed: U8.3 (~Q), U11.1
unnamed: U4.4, U8.2 (D), U11.2
unnamed: U11.4, U12.2 (D)
VCM: U3.8 (VCM); also elsewhere on the board

Notes on the sheet:
TI suffix DBV = SOT23 TI suffix DCK = SC70 TI suffix DCT = SM8 (SSOP, 0.65 mm pitch) TI suffix DCU = VSSOP (MSOP, 0.5 mm pitch)
Output decoupling resistors connected to all ADC pins, even to NC pins, for easier later upgrade to ADC3664 etc.
AUC family: made for 50..65 Ohms TL impedance

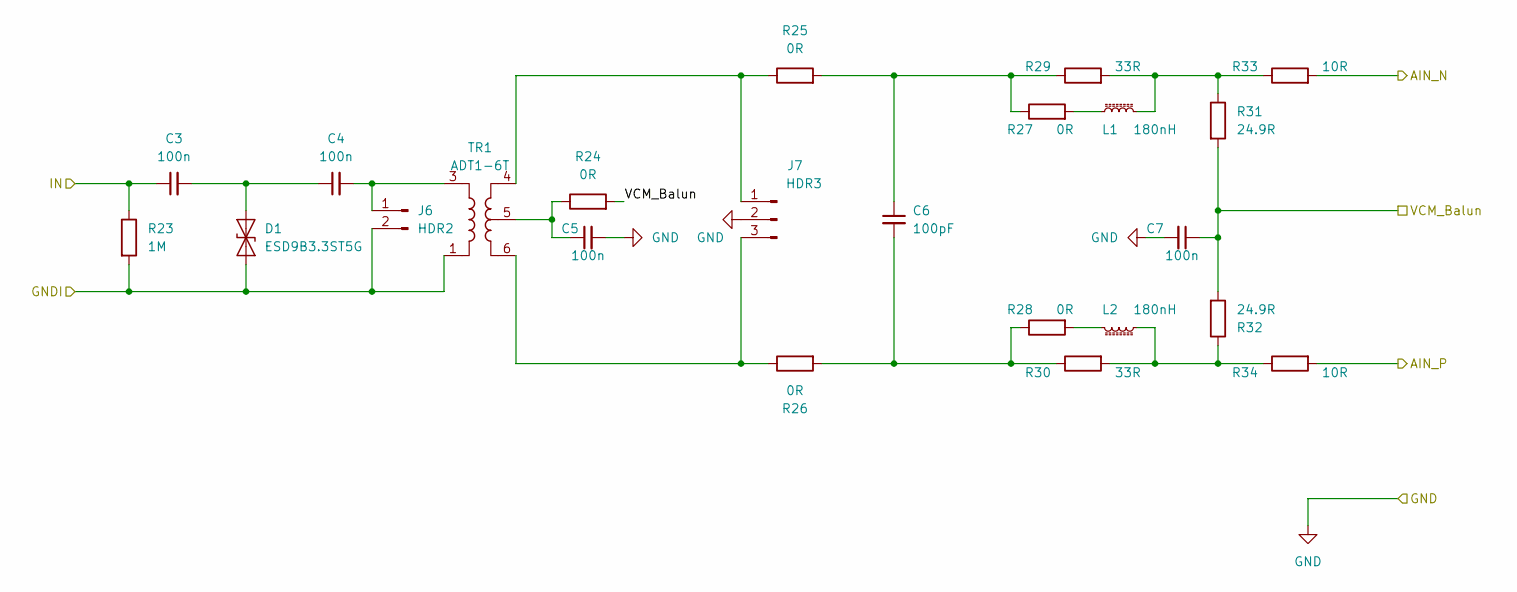
[picture p11: schematic ADCINP.kicad_sch, H7DDCADC]

Parts:
C3, C4, C5, C7: 100n; C_0805_2012Metric
C6: 100pF; C_0805_2012Metric
D1: ESD9B3.3ST5G; D_SOD-923
J6: HDR2; PinHeader_1x02_P2.54mm_Vertical
J7: HDR3; PinHeader_1x03_P2.54mm_Vertical
L1, L2: 180nH; R_0805_2012Metric
R23: 1M; R_0805_2012Metric
R24, R25, R26, R27, R28: 0R; R_0805_2012Metric
R29, R30: 33R; R_0805_2012Metric
R31, R32: 24.9R; R_0805_2012Metric
R33, R34: 10R; R_0805_2012Metric
TR1: ADT1-6T; Mini-Circuits_CD637_H5.23mm

Connections:
/ADC/AIN_N: R33.2; also elsewhere on the board
/ADC/AIN_P: R34.2; also elsewhere on the board
/GNDI_A: D1.1 (A1), J6.2, R23.2, TR1.1; also elsewhere on the board
/IN_A_50: C3.1, R23.1; also elsewhere on the board
GND: C5.2, C7.2, J7.2; also elsewhere on the board
unnamed: C3.2, C4.1, D1.2 (A2)
unnamed: C4.2, J6.1, TR1.3
unnamed: C5.1, R24.1, TR1.5
unnamed: C6.1, R25.2, R27.1, R29.1
unnamed: C6.2, R26.2, R28.1, R30.1
unnamed: J7.1, R25.1, TR1.4
unnamed: J7.3, R26.1, TR1.6
unnamed: L1.1, R27.2
unnamed: L1.2, R29.2, R31.1, R33.1
unnamed: L2.1, R28.2
unnamed: L2.2, R30.2, R32.1, R34.1
VCM: C7.1, R24.2, R31.2, R32.2; also elsewhere on the board

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
