papamidas/H7DDCADC/H7DDCADC.kicad_pcb

## KiCad design H7DDCADC.kicad_pcb (continued)

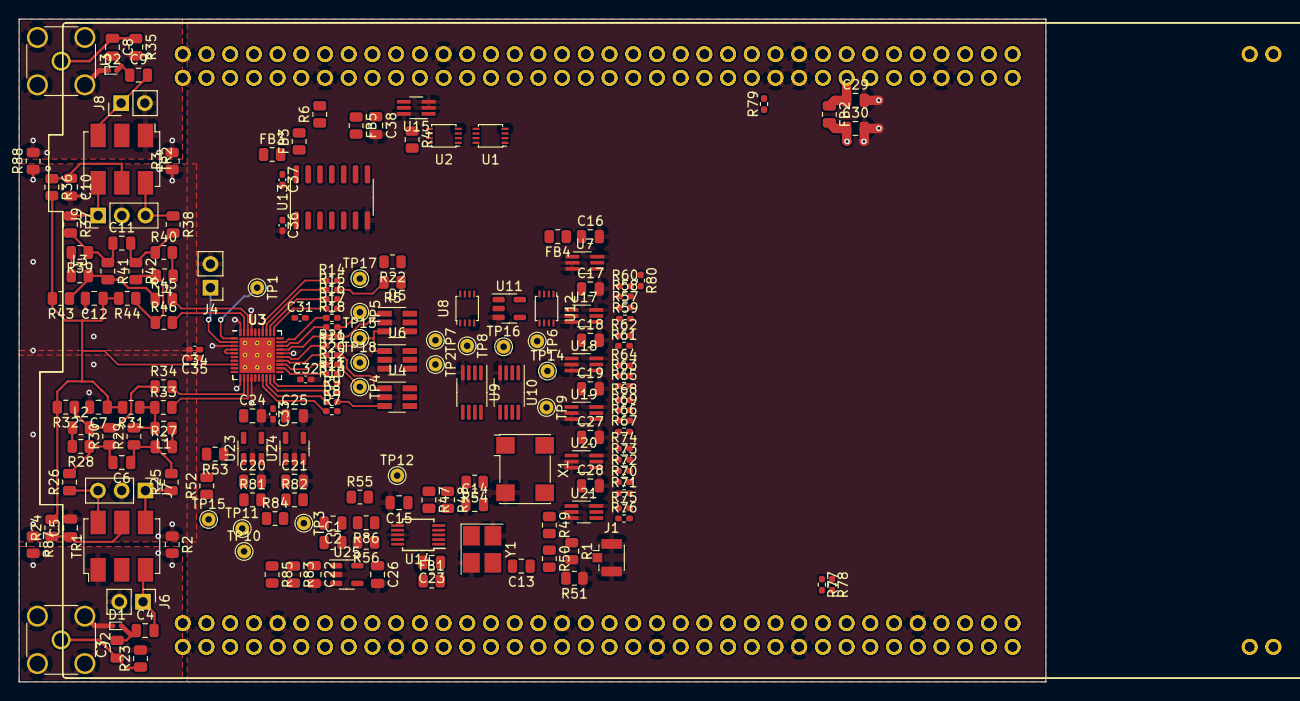
[picture p12: board H7DDCADC.kicad_pcb from above]

Board: 4 copper layers, 110.0 x 71.0 mm, 194 parts (0 on the bottom side), 145 nets.

Other parts of the board:
C8, C9, C10, C12: 100n; C_0805_2012Metric
C11: 100pF; C_0805_2012Metric
D2: ESD9B3.3ST5G; D_SOD-923
FB3#2, FB4: Ferrite_0805; R_0805_2012Metric
J8: HDR2; PinHeader_1x02_P2.54mm_Vertical
J9: HDR3; PinHeader_1x03_P2.54mm_Vertical
L3, L4: 180nH; R_0805_2012Metric
R35: 1M; R_0805_2012Metric
R36, R37, R38, R39, R40: 0R; R_0805_2012Metric
R41, R42: 33R; R_0805_2012Metric
R43, R44: 24.9R; R_0805_2012Metric
R45, R46: 10R; R_0805_2012Metric
TR2: ADT1-6T; Mini-Circuits_CD637_H5.23mm
U3#2: ADC3660IRSBT; QFN-40-1EP_5x5mm_P0.4mm_EP3.6x3.6mm
U16#2: NUCLEO144-H743ZI; ST_Morpho_Connector_144_STLink

Their connections:
+3.3VF: FB3#2.2, FB4.2; also elsewhere on the board
+3V3: U16#2.16 (+3V3); also elsewhere on the board
/ADC/AIN_N: U3#2.13 (AINM); also elsewhere on the board
/ADC/AIN_P: U3#2.12 (AINP); also elsewhere on the board
/ADC/BIN_N: R45.2, U3#2.38 (BINM); also elsewhere on the board
/ADC/BIN_P: R46.2, U3#2.39 (BINP); also elsewhere on the board
/ADC/CLKN_ADC: U3#2.7 (CLKM); also elsewhere on the board
/ADC/CLKP_ADC: U3#2.6 (CLKP); also elsewhere on the board
/ADC/PDN_SYNC: U3#2.1 (PDN/SYNC); also elsewhere on the board
/ADC/RESET: U3#2.9 (RESET); also elsewhere on the board
/ADC/SCLK: U3#2.35 (SCLK); also elsewhere on the board
/ADC/SDIO: U3#2.10 (SDIO); also elsewhere on the board
/ADC/SEN: U3#2.16 (/SEN); also elsewhere on the board
/ADC/VREF: U3#2.2 (VREF); also elsewhere on the board
/GNDI_B: D2.1 (A1), J8.2, R35.2, TR2.1; also elsewhere on the board
/IN_B_50: C8.1, R35.1; also elsewhere on the board
/MCU/+5V: U16#2.18 (+5V); also elsewhere on the board
/MCU/E5V: U16#2.6 (E5V); also elsewhere on the board
/MCU/I2C1_SCL_A: U16#2.89 (PB6); also elsewhere on the board
/MCU/I2C1_SCL_B: U16#2.75 (PB8); also elsewhere on the board
/MCU/I2C1_SDA_A: U16#2.21 (LD2/PB7); also elsewhere on the board
/MCU/PE1: U16#2.61 (PE1); also elsewhere on the board
/MCU/PF0_50: U16#2.53 (PF0); also elsewhere on the board
/MCU/SPI2_MOSI_A: U16#2.36 (ETH_MDC/PC1); also elsewhere on the board
/MCU/SPI2_MOSI_B: U16#2.37 (PC3); also elsewhere on the board
/MCU/SPI2_MOSI_C: U16#2.98 (PB15); also elsewhere on the board
/MCU/SPI2_NSS_A: U16#2.88 (PB12); also elsewhere on the board
/MCU/SPI2_NSS_B: U16#2.86 (USB_DM/PA11); also elsewhere on the board
/MCU/SPI2_NSS_C: U16#2.99 (PB4); also elsewhere on the board
/MCU/SPI2_NSS_D: U16#2.77 (PB9); also elsewhere on the board
/MCU/SPI2_SCK_A: U16#2.97 (PB10); also elsewhere on the board
/MCU/SPI2_SCK_B: U16#2.102 (ETH_TXD1/PB13); also elsewhere on the board
/MCU/SPI2_SCK_C: U16#2.93 (USB_VBUS/PA9); also elsewhere on the board
/MCU/SPI2_SCK_D: U16#2.84 (USB_DP/PA12); also elsewhere on the board
/MCU/SPI2_SCK_E: U16#2.40 (PD3); also elsewhere on the board
/MCU/SPI3_MOSI_A: U16#2.94 (PB2); also elsewhere on the board
/MCU/SPI3_MOSI_B: U16#2.101 (PB5); also elsewhere on the board
/MCU/SPI3_MOSI_C: U16#2.43 (PD6); also elsewhere on the board
/MCU/SPI3_MOSI_D: U16#2.3 (PC12); also elsewhere on the board
/MCU/SPI3_NSS_A: U16#2.17 (PA15); also elsewhere on the board
/MCU/SPI3_NSS_B: U16#2.32 (PA4); also elsewhere on the board
/MCU/SPI3_SCK_A: U16#2.1 (PC10); also elsewhere on the board
/MCU/SPI3_SCK_B: U16#2.103 (SWO/PB3); also elsewhere on the board
/MCU/SPI4_MISO: U16#2.50 (PE5); also elsewhere on the board
/MCU/SPI4_MOSI: U16#2.62 (PE6); also elsewhere on the board
/MCU/SPI4_NSS: U16#2.48 (PE4); also elsewhere on the board
/MCU/SPI4_SCK: U16#2.46 (PE2); also elsewhere on the board
/MCU/U5V: U16#2.80 (U5V); also elsewhere on the board
/MCU/VDD: U16#2.5 (VDD); also elsewhere on the board
/MCU/VIN: U16#2.24 (VIN); also elsewhere on the board
AVDD: U3#2.4 (REFBUF), U3#2.5 (AVDD), U3#2.15 (AVDD), U3#2.36 (AVDD); also elsewhere on the board
GND: C10.2, C12.2, J9.2, U3#2.3 (REFGND), U3#2.11 (GND), U3#2.14 (GND), U3#2.26 (IOGND), U3#2.37 (GND), U3#2.40 (GND), U3#2.41 (GND_PAD), U16#2.8 (GND), U16#2.19 (GND), U16#2.20 (GND), U16#2.22 (GND), U16#2.49 (GND), U16#2.60 (GND), U16#2.71 (GND), U16#2.72 (GND), U16#2.81 (GND), U16#2.92 (GND), U16#2.104 (AGND), U16#2.111 (GND), U16#2.126 (GND), U16#2.135 (GND), U16#2.143 (GND), U16#2.144 (GND); also elsewhere on the board
IOVDD: U3#2.21 (IOVDD), U3#2.30 (IOVDD); also elsewhere on the board
unnamed: C8.2, C9.1, D2.2 (A2)
unnamed: C9.2, J8.1, TR2.3
unnamed: C10.1, R36.1, TR2.5
unnamed: C11.1, R37.2, R39.1, R41.1
unnamed: C11.2, R38.2, R40.1, R42.1
unnamed: J9.1, R37.1, TR2.4
unnamed: J9.3, R38.1, TR2.6
unnamed: L3.1, R39.2
unnamed: L3.2, R41.2, R43.1, R45.1
unnamed: L4.1, R40.2
unnamed: L4.2, R42.2, R44.1, R46.1
unnamed 107: U3#2.17 (NC); also elsewhere on the board
unnamed 108: U3#2.18 (FCLK); also elsewhere on the board
unnamed 109: U3#2.19 (NC); also elsewhere on the board
unnamed 110: U3#2.20 (NC); also elsewhere on the board
unnamed 111: U3#2.22 (NC); also elsewhere on the board
unnamed 112: U3#2.23 (DA5); also elsewhere on the board
unnamed 113: U3#2.24 (DA6); also elsewhere on the board
unnamed 114: U3#2.34 (NC); also elsewhere on the board
unnamed 115: U3#2.33 (DCLKIN); also elsewhere on the board
unnamed 116: U3#2.32 (NC); also elsewhere on the board
unnamed 117: U3#2.31 (NC); also elsewhere on the board
unnamed 118: U3#2.29 (NC); also elsewhere on the board
unnamed 119: U3#2.28 (DB5); also elsewhere on the board
unnamed 120: U3#2.27 (DB6); also elsewhere on the board
unnamed 121: U3#2.25 (DCLK); also elsewhere on the board
V1T97: FB4.1; also elsewhere on the board
VCM: C12.1, R36.2, R43.2, R44.2, U3#2.8 (VCM); also elsewhere on the board
