papamidas/H7DDCADC/(commit log)

2022-07-10 annotated and packages defined
    [ADC.kicad_sch, ADCINP.kicad_sch, ADCTRANSL.kicad_sch, CLKGEN.kicad_sch, H7DDCADC.kicad_sch, MCU.kicad_sch, POWER.kicad_sch, TRANSLATE4.kicad_sch]
2022-07-17 placement_in_progress 1
    [ADC.kicad_sch, ADCTRANSL.kicad_sch, H7DDCADC.kicad_pcb, H7DDCADC.kicad_sch, MCU.kicad_sch, TRANSLATE4.kicad_sch]
2022-07-22 placement 80 percent
    [ADC.kicad_sch, CLKGEN.kicad_sch, H7DDCADC.kicad_pcb, H7DDCADC.kicad_sch, MCU.kicad_sch]
2022-07-26 routing in progress 1
    [ADC.kicad_sch, H7DDCADC.kicad_pcb, H7DDCADC.kicad_sch, MCU.kicad_sch, POWER.kicad_sch, TRANSLATE4.kicad_sch]
2022-07-27 routing in progress 2
    [ADC.kicad_sch, ADCTRANSL.kicad_sch, H7DDCADC.kicad_sch]
2022-07-27 routing done
    [H7DDCADC.kicad_sch, MCU.kicad_sch]
2022-07-28 Silkscreen edited
2022-07-29 JLCPCB order
    [H7DDCADC-B_Cu.gbl, H7DDCADC-B_Mask.gbs, H7DDCADC-B_Paste.gbp, H7DDCADC-B_Silkscreen.gbo, H7DDCADC-Edge_Cuts.gm1, H7DDCADC-F_Cu.gtl, H7DDCADC-F_Mask.gts, H7DDCADC-F_Paste.gtp]
